Sheethal00/emg-diy/docs/breadboard_layout.png

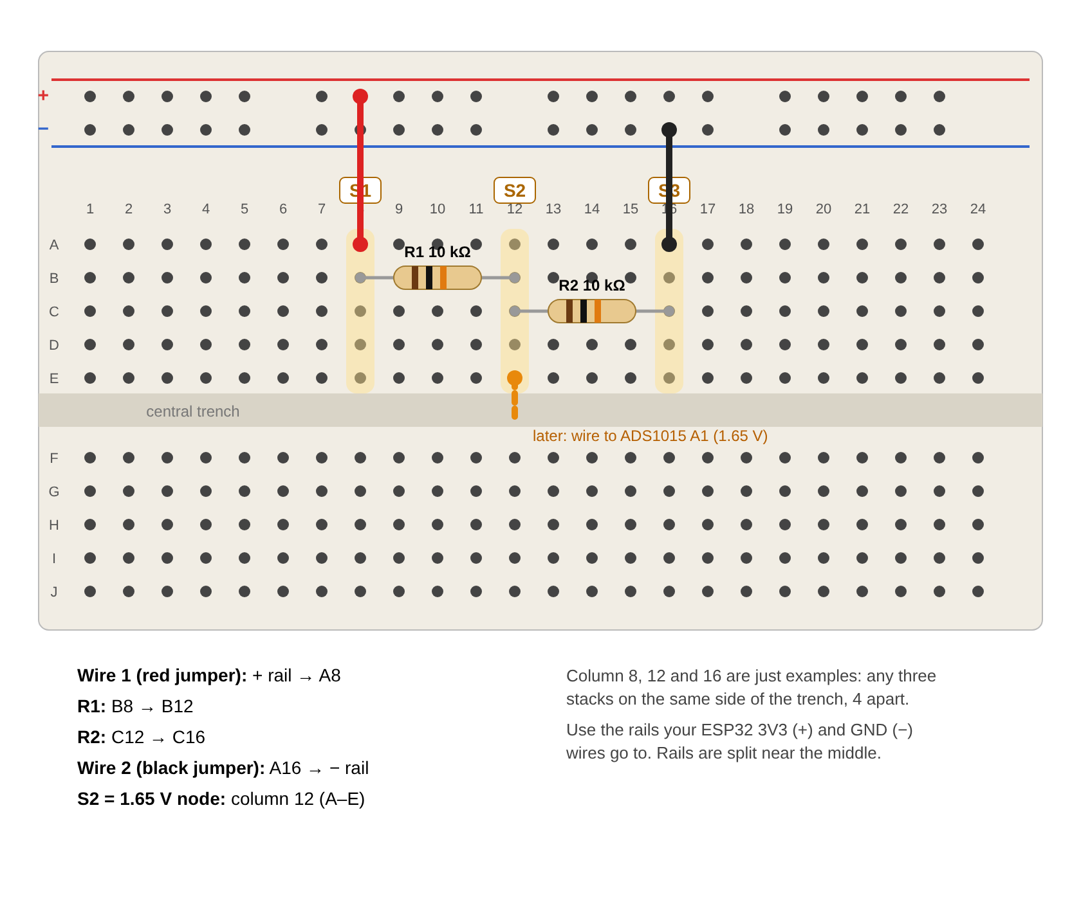
docs/breadboard_layout.png
