Sheethal00/emg-diy/docs/shopping_list.xlsx

EMG build: shopping list
Legend: yellow cells are for you to edit. Blue text = typed-in numbers. Black = formulas. Prices are in rupees, include GST where listed, and exclude shipping.
Number of channels (1 to 4) | 1 | Items marked 'Per channel = Yes' scale with this number.
Category | Item | Per channel? | Qty (1 channel) | Qty needed | Unit price (Rs) | Est. cost (Rs) | Bought? (Yes) | Price basis | Notes
Ordered chips | INA333AIDGKR instrumentation amp | Yes | 3 |  | Rs 243 |  |  | Verified | Robu.in, 1-9 pcs, incl. GST. Edit qty to match what you ordered. Price drops to Rs 211 at 10+ pcs
Ordered chips | OPA2333AIDGKR dual op amp | Yes | 3 |  | Rs 339 |  |  | Verified | Robu.in, 1-9 pcs, incl. GST. Edit qty to match what you ordered. Rs 294 at 10-19 pcs
Modules and power | ADS1015 ADC module (not ADS1115) | Yes | 1 |  | Rs 299 |  |  | Verified | One per channel. Probots Rs 299 (Hubtronics listed Rs 233). Check the chip marking on arrival
Modules and power | ESP32 DevKit, classic ESP32 (WROOM), 38-pin, Type-C | No | 1 |  | Rs 499 |  |  | Verified | Probots PRO5004, headers soldered. Not S2, S3 or C3: they lack Bluetooth Classic. You also need a USB-C data cable
Modules and power | SOP8/TSSOP8/MSOP8 to DIP8 adapter (0.65 mm side) | Yes | 3 |  | Rs 30 |  |  | Verified | Probots PRO2858, Rs 30. NOT the MSOP10/SOT23 board (0.5 mm pitch)
Later: battery power | 3.3 V buck-boost or 5 V boost power module | No | 1 |  | Rs 200 |  |  | Estimate | Decide later. Not the boost-only 7Semi module. Check it supplies 600 mA or more
Later: battery power | LiPo battery, 3.7 V 500 mAh, with protection | No | 1 |  | Rs 299 |  |  | Verified | Probots PRO4830, bare leads: add a connector. Needed before wearing electrodes
Later: battery power | TP4056 charger module | No | 1 |  | Rs 70 |  |  | Estimate | Reduce charge current for a 500 mAh cell. Charge only when not worn
Later: battery power | Slide switch, 1 A fuse or PTC, JST connector | No | 1 |  | Rs 75 |  |  | Estimate | Small kit
Resistors | 12 kOhm, 1% (gain resistor Rg1; substitute for 11 kOhm) | Yes | 2 |  | Rs 20 |  |  | Estimate | Gain 1+100k/12k = 9.3 (vs 10.1 with 11k). 10k+1k in series gives exactly 11k. With 47k R7 use dashboard --gain 448
Resistors | 10 kOhm, 1% (reference divider, R11) | No | 4 |  | Rs 3 |  |  | Estimate | Shared by all channels
Resistors | 1 kOhm, 1% | Yes | 6 |  | Rs 3 |  |  | Estimate | R3, R4, R8, R10 plus spares
Resistors | 47 kOhm, 1% (gain stage R7; substitute for 49.9 kOhm) | Yes | 2 |  | Rs 3 |  |  | Estimate | Gain 1+47k/1k = 48. Low-pass with 6.8 nF is about 498 Hz. With 12k Rg the total gain is about 448: use dashboard --gain 448
Resistors | 24.9 kOhm, 1% (lower-gain option) | No | 1 |  | Rs 3 |  |  | Estimate | Only if strong flexes clip
Resistors | 8.2 kOhm (high-pass R9) | Yes | 2 |  | Rs 3 |  |  | Estimate
Resistors | 10 MOhm (optional bias return R5, R6) | Yes | 2 |  | Rs 3 |  |  | Estimate | Optional
Resistors | 100 kOhm (signal test divider) | No | 2 |  | Rs 3 |  |  | Estimate | For the amplifier signal test (DAC divider, no electrodes)
Resistors | 100 Ohm (signal test divider) | No | 2 |  | Rs 3 |  |  | Estimate | For the amplifier signal test (DAC divider, no electrodes)
Resistors | 10 kOhm potentiometer | No | 1 |  | Rs 25 |  |  | Estimate | For the ADS1015 test
Capacitors and other parts | 1 uF capacitor (C1, C6) | Yes | 3 |  | Rs 8 |  |  | Estimate | Film or ceramic
Capacitors and other parts | 6.8 nF capacitor (C2), C0G if possible | Yes | 2 |  | Rs 8 |  |  | Estimate
Capacitors and other parts | 1 nF capacitor (C3, C4) | Yes | 4 |  | Rs 5 |  |  | Estimate
Capacitors and other parts | 10 nF capacitor (C5) | Yes | 3 |  | Rs 5 |  |  | Estimate
Capacitors and other parts | 0.1 uF capacitor, decoupling | Yes | 10 |  | Rs 3 |  |  | Estimate | One at every IC supply pin
Capacitors and other parts | 10 uF capacitor, bulk | No | 3 |  | Rs 6 |  |  | Estimate
Capacitors and other parts | Ferrite bead | No | 2 |  | Rs 10 |  |  | Estimate | Separates analog 3.3 V from the ESP32
Building supplies | Perfboard | No | 2 |  | Rs 60 |  |  | Estimate
Building supplies | Breadboard | No | 1 |  | Rs 90 |  |  | Estimate
Building supplies | Header pins and jumper wires | No | 1 |  | Rs 120 |  |  | Estimate
Building supplies | Hookup wire | No | 1 |  | Rs 100 |  |  | Estimate
Building supplies | Thin solder with flux, flux pen | No | 1 |  | Rs 200 |  |  | Estimate | 0.5-0.8 mm solder
Building supplies | Shielded cable or 3.5 mm audio cable | No | 1 |  | Rs 100 |  |  | Estimate | Audio cable also serves the signal test
Body side | Snap gel electrodes, Ag/AgCl, pack of 50 | No | 1 |  | Rs 500 |  |  | Estimate | ECG type; same type and batch for a pair
Body side | Snap lead wires or connectors | Yes | 3 |  | Rs 80 |  |  | Estimate | Two sensing plus one reference per channel
Body side | Alcohol swabs | No | 1 |  | Rs 60 |  |  | Estimate
Body side | Skin-prep abrasive pads | No | 1 |  | Rs 100 |  |  | Estimate
Body side | Skin marker | No | 1 |  | Rs 50 |  |  | Estimate | To mark electrode spots
Body side | Armband or belt pouch for the box | No | 1 |  | Rs 250 |  |  | Estimate
Tools | Multimeter | No | 1 |  | Rs 900 |  |  | Estimate | Skip if you already have one
Tools | Temperature-controlled soldering iron | No | 1 |  | Rs 1000 |  |  | Estimate | Skip if you already have one
Tools | Fine tweezers and magnifier | No | 1 |  | Rs 350 |  |  | Estimate
Tools | Side cutters | No | 1 |  | Rs 150 |  |  | Estimate
Tools | Desoldering wick | No | 1 |  | Rs 100 |  |  | Estimate
Totals
Ordered chips
Modules and power
Later: battery power
Resistors
Capacitors and other parts
Building supplies
Body side
Tools
Total, everything
Total, excluding tools and battery power
Still to buy (not marked Yes)
Notes
Prices marked Verified come from listings seen on Robu.in, Probots and Hubtronics. Every other price is a rough estimate: check before buying.
Spares are included for one channel. Buy a few extras of the cheap parts. Do not wear electrodes while USB is connected: buy the battery power items before the first recording on your body.
Adapter boards must be MSOP-8 or VSSOP-8, not SOIC. The ESP32 must be the classic version for Bluetooth.
The Robu INA333 price drops to Rs 211 at 10 or more pieces, so a four-channel order may be cheaper per piece.
