Sheethal00/emg-diy/(commit log)

2026-11-05 DIY sEMG recorder: firmware, dashboard, tests, docs, animation
    [shopping_list.xlsx]
2026-11-05 Shopping list: substitute 12k Rg and 51k R7, update test-divider notes
    [shopping_list.xlsx]
2026-11-05 Shopping list: R7 substitute is 47k, total gain about 448
    [shopping_list.xlsx]
2026-11-05 Add Day 1 test circuit build and expected-output guide
2026-11-05 Add Breadboard Bench simulator page
    Interactive breadboard simulator with the Day 1 test circuits, based on
    docs/TEST_CIRCUITS.md, firmware/emg_firmware.ino and tests/dac_test/dac_test.ino.
    Claude-Session: https://claude.ai/code/session_01VtrYCrmmSUTc2R2eVoh5zs
